SamuelSkinner/Claymore/claymore/hardware with labels.PNG

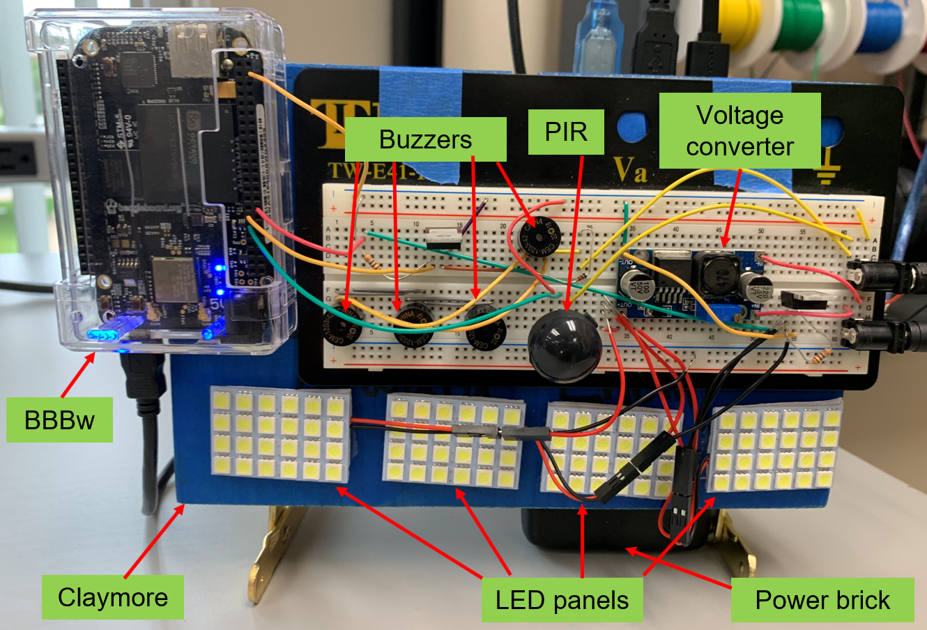
claymore/hardware with labels.PNG
