SamuelSkinner/Claymore/datasheets/LED Information.PNG

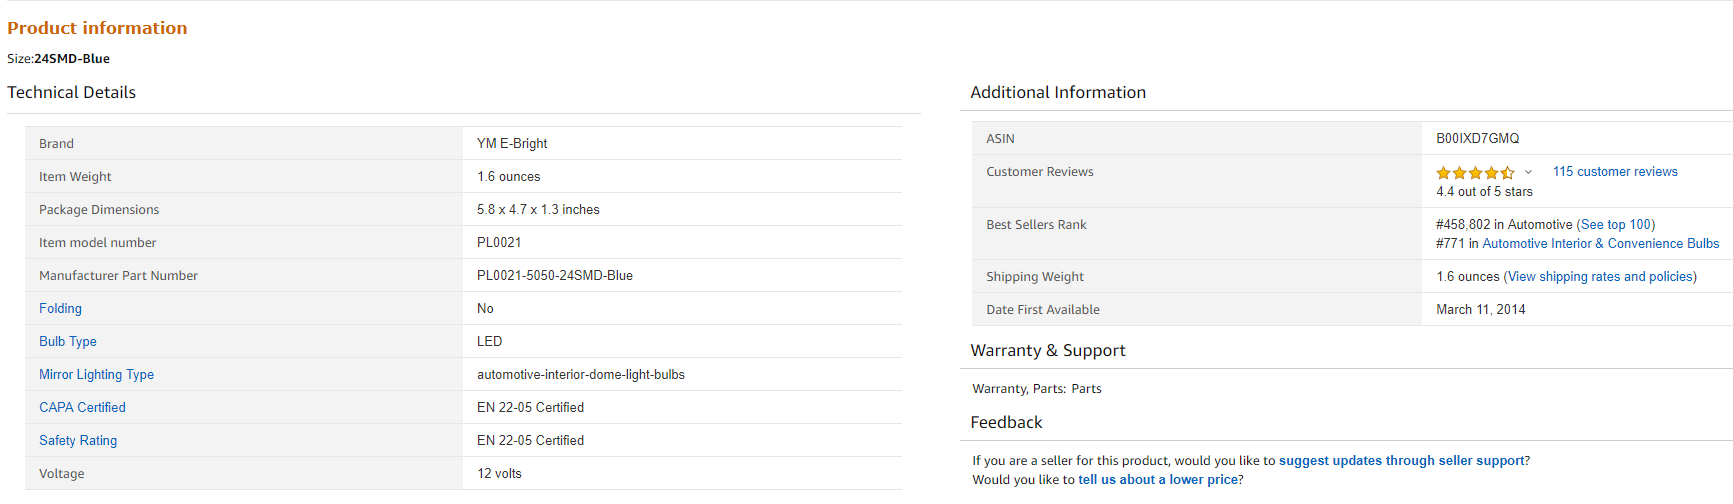
datasheets/LED Information.PNG
