SamuelSkinner/Claymore/datasheets/Voltage Converter Information.PNG

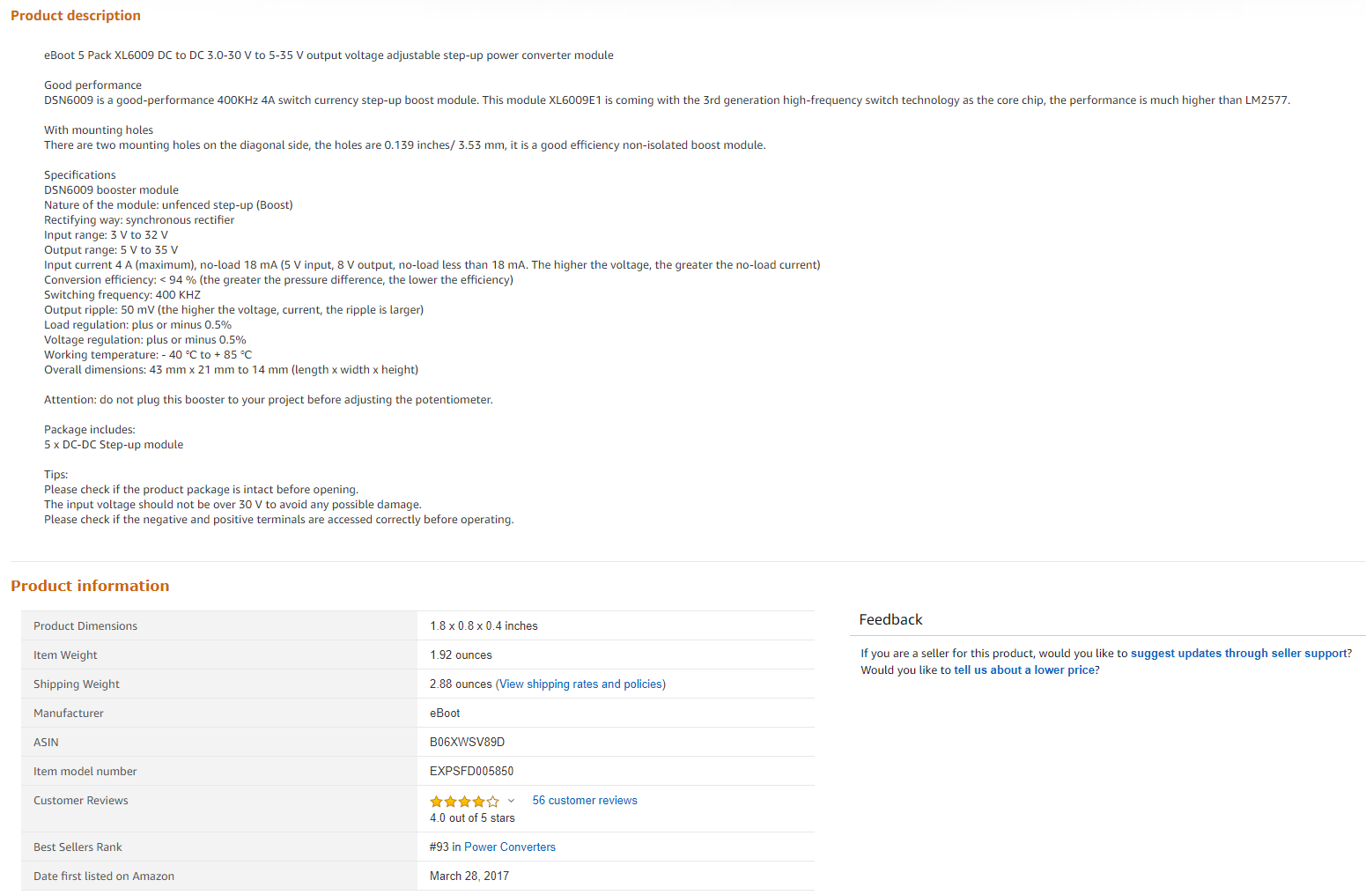
datasheets/Voltage Converter Information.PNG
