SamuelSkinner/Claymore/Parts List.xlsx

Group | Qty | Descriptive Name of Part | Vendor | Link | Unit Cost | Total Cost | Department Purchase (Y or N)
6 | 1 | 12 m Motion Sensor | Digi-Key | https://www.digikey.com/product-detail/en/panasonic-electric-works/EKMC2603112K/255-6283-ND/9356927 | $13.35 | $13.35 | N
6 | 1 | LED Panel | Amazon | https://www.amazon.com/Everbrightt-Reading-Interior-Festoon-Adapters/dp/B00IXD7GOE?s=gateway | $10.49 | $23.84 | N
6 | 4 | 95 dB Speaker | Digi-Key | https://www.digikey.com/product-detail/en/cui-inc/CEM-1203-42/102-1153-ND/412412 | $0.83 | $27.16 | N
6 | 1 | 22 Ah Power Bank, 5.8 A Output | Amazon | https://www.amazon.com/Portable-RAVPower-22000mAh-Li-polymer-Smartphone/dp/B01G1XH46M | $41.99 | $69.15 | N
6 | 1 | 3-30 V to 5-35 V Step Up Voltage Converter | Amazon | https://www.amazon.com/eBoot-Converter-Voltage-Adjustable-Step-up/dp/B06XWSV89D?s=electronics | $13.65 | $82.80 | N
6 | 1 | Beaglebone Wireless | Digi-Key | https://www.digikey.com/product-detail/en/ghi-electronics,-llc/BBBWL-SC-562/BBBWL-SC-562-ND/6211000?WT.srch=1 | $76.13 | $158.93 | N
