SamuelSkinner/Claymore/(list of files, drawings)

Other design files:
Schematic.SchDoc
