SamuelSkinner/Claymore/(commit log)

2019-05-08 Added datasheets
    [Parts List.xlsx]
2019-05-08 Updated diagrams and schematic
    [Schematic.SchDoc]
